dickersonbetry-alt/-fpga-/rk3588/ball_v2/confusion_matrix.png

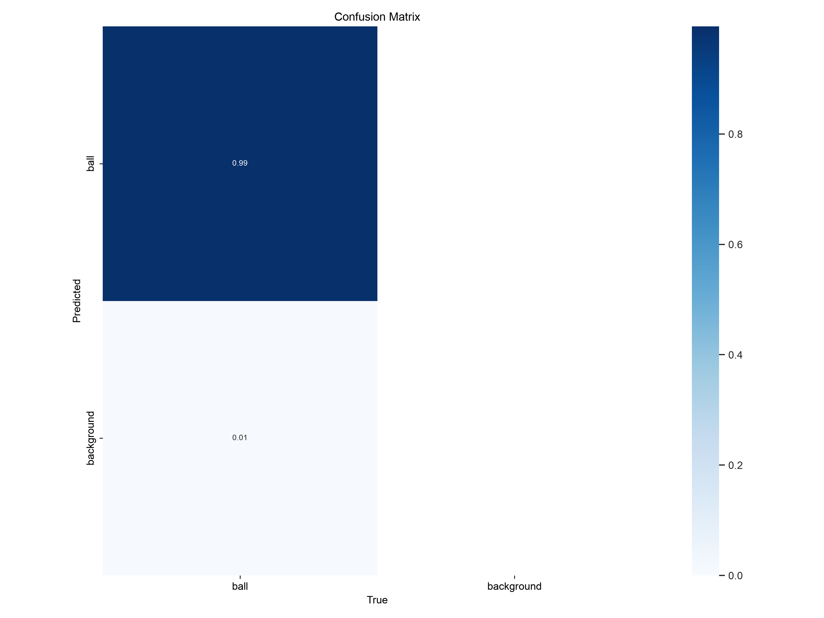
rk3588/ball_v2/confusion_matrix.png
