dickersonbetry-alt/-fpga-/rk3588/ball_v2/F1_curve.png

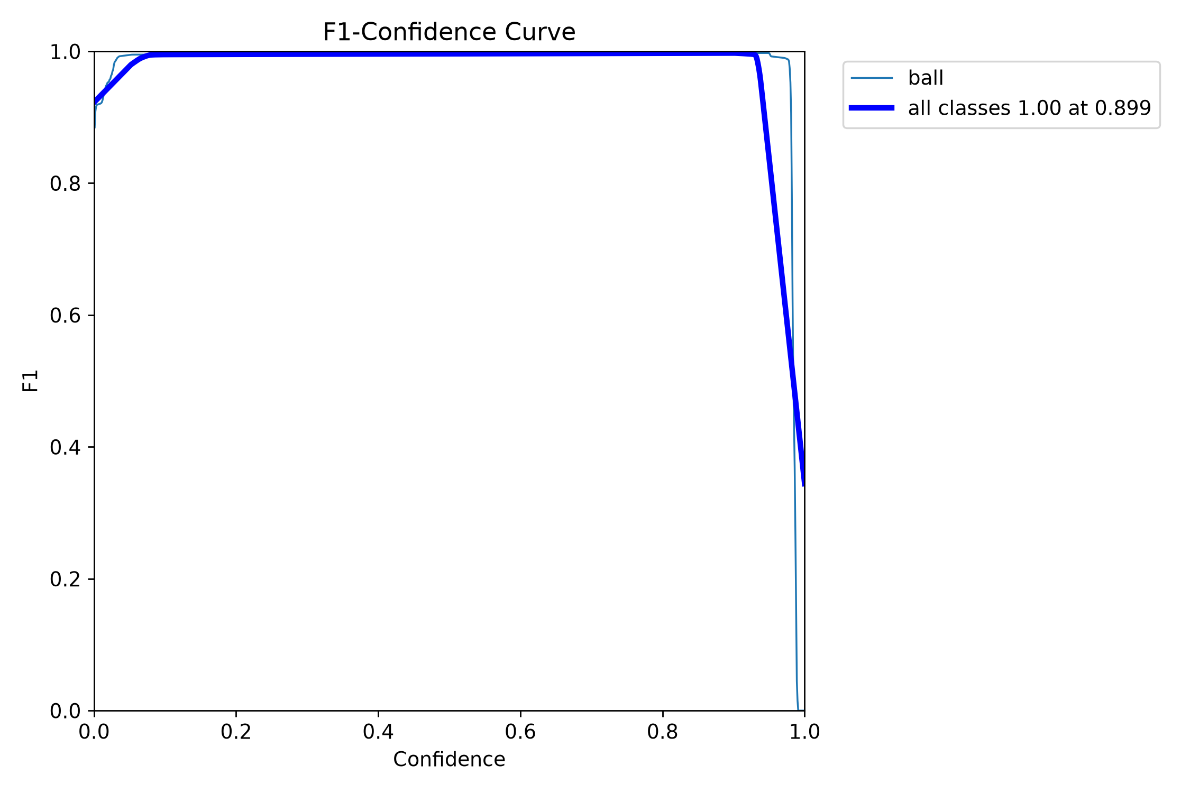
rk3588/ball_v2/F1_curve.png
