dickersonbetry-alt/-fpga-/rk3588/ball_v2/labels.jpg

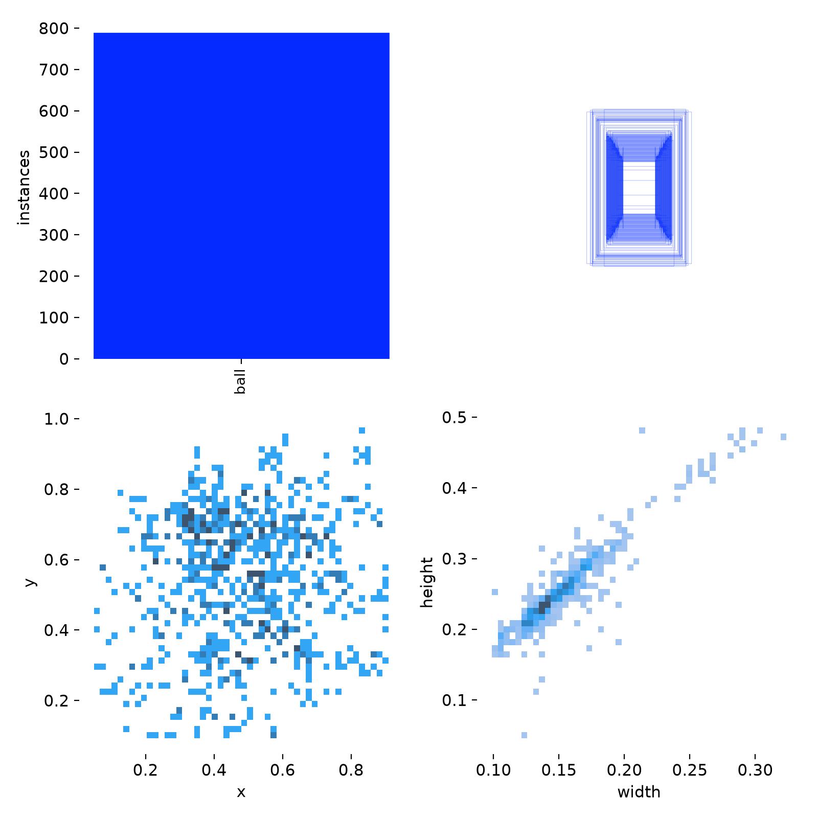
rk3588/ball_v2/labels.jpg
