dickersonbetry-alt/-fpga-/rk3588/ball_v2/labels_correlogram.jpg

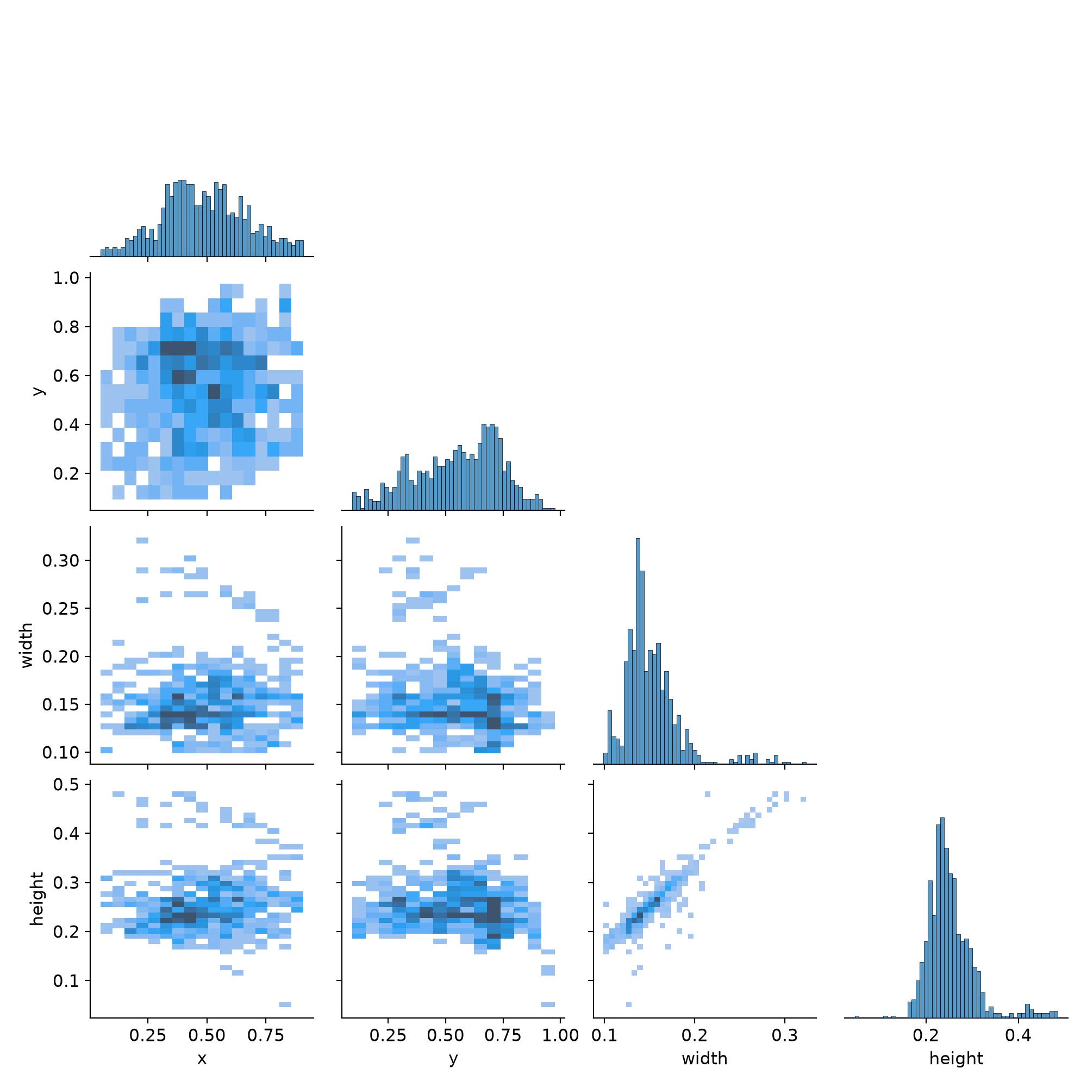
rk3588/ball_v2/labels_correlogram.jpg
