dickersonbetry-alt/-fpga-/rk3588/ball_v2/PR_curve.png

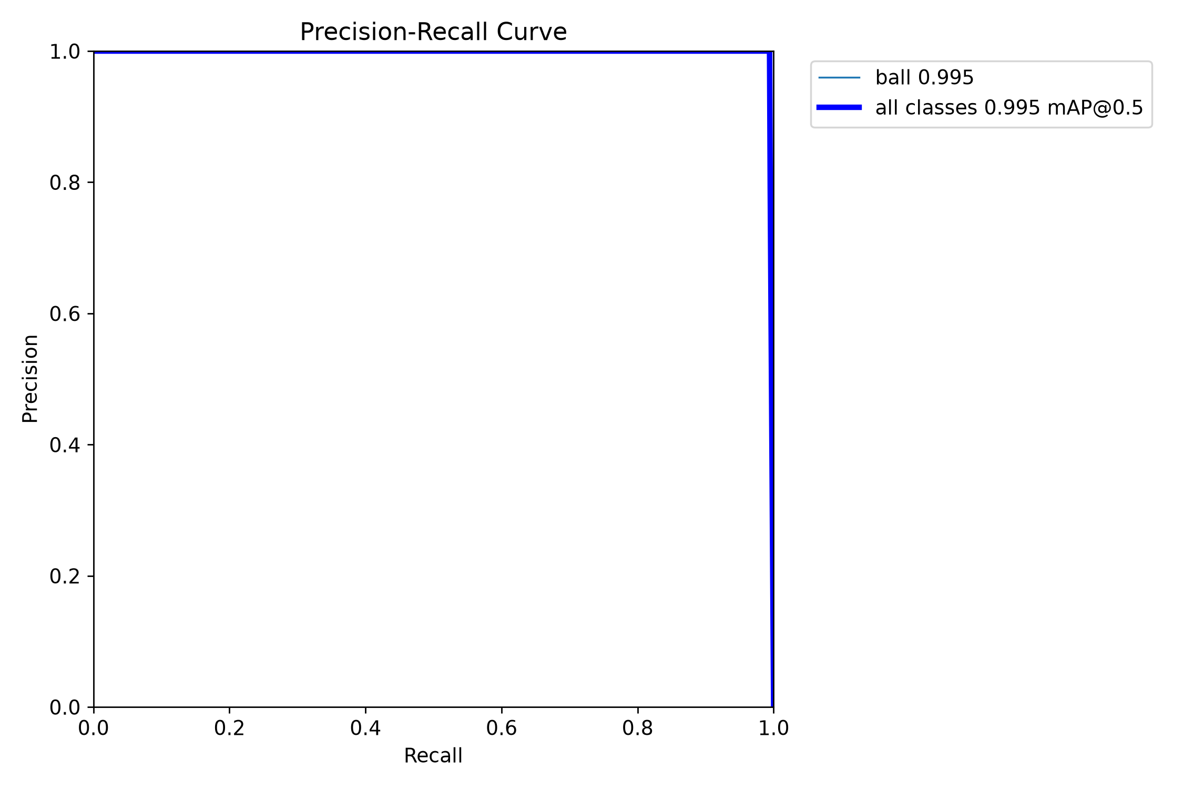
rk3588/ball_v2/PR_curve.png
