dickersonbetry-alt/-fpga-/rk3588/ball_v2/train_batch0.jpg

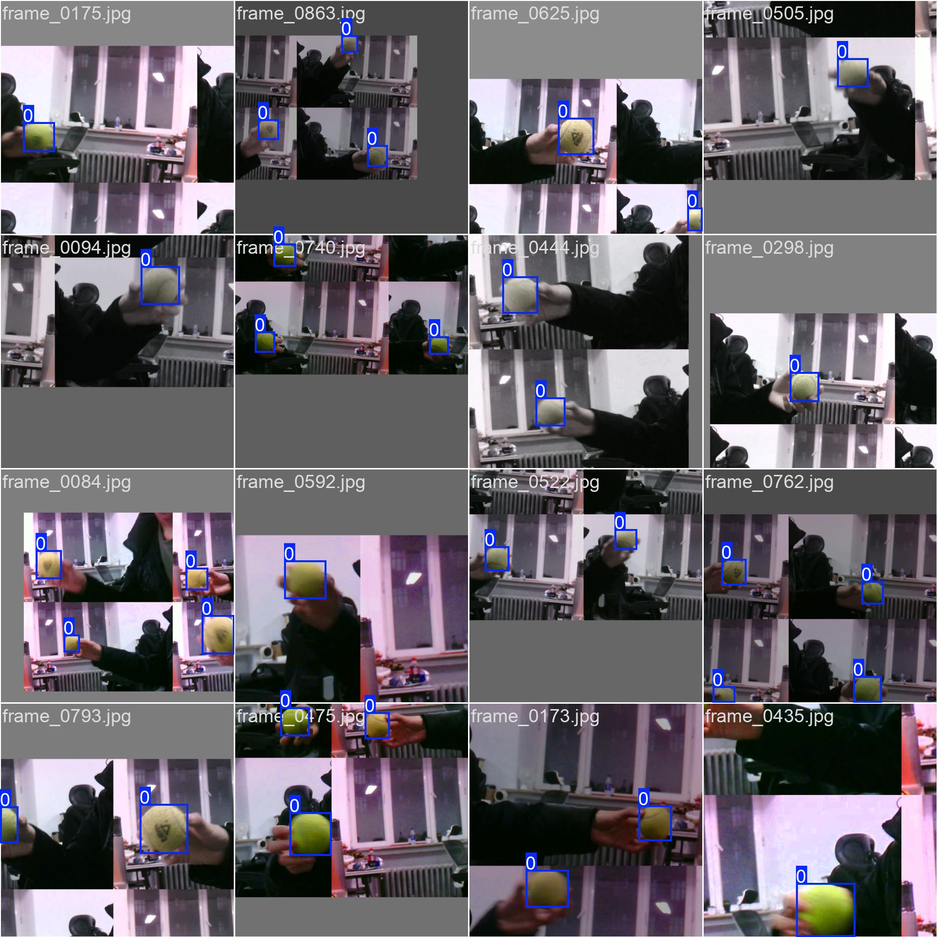
rk3588/ball_v2/train_batch0.jpg
