dickersonbetry-alt/-fpga-/rk3588/ball_v2/train_batch1.jpg

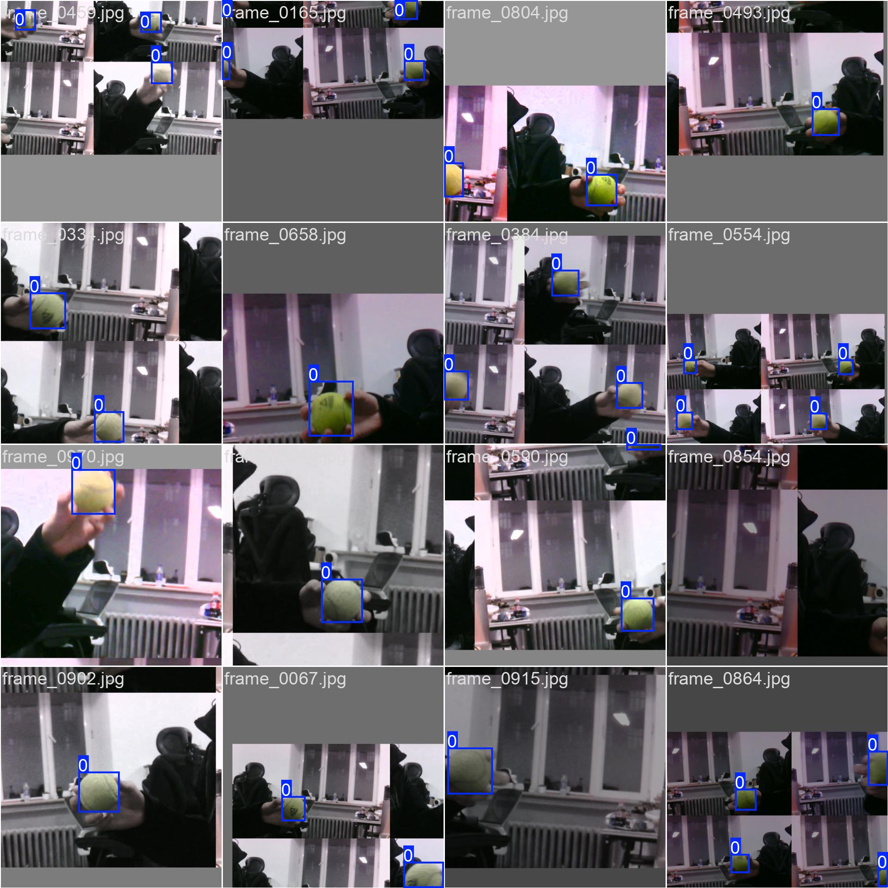
rk3588/ball_v2/train_batch1.jpg
