dickersonbetry-alt/-fpga-/rk3588/ball_v2/train_batch2.jpg

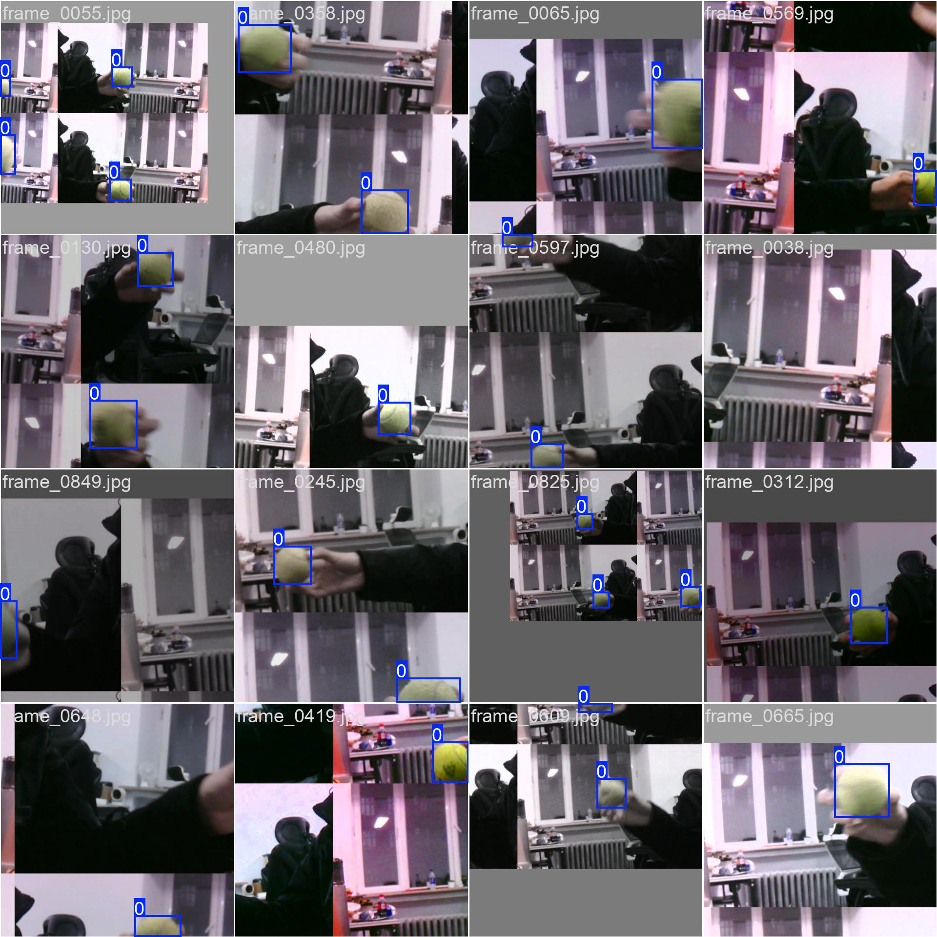
rk3588/ball_v2/train_batch2.jpg
