dickersonbetry-alt/-fpga-/rk3588/ball_v2/val_batch1_labels.jpg

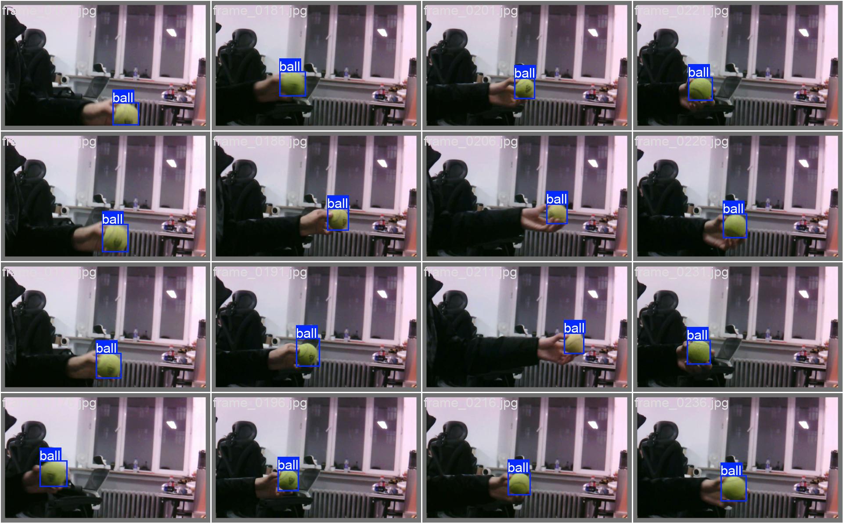
rk3588/ball_v2/val_batch1_labels.jpg
