dickersonbetry-alt/-fpga-/fpga/sw/52B_ASM.SLDASM

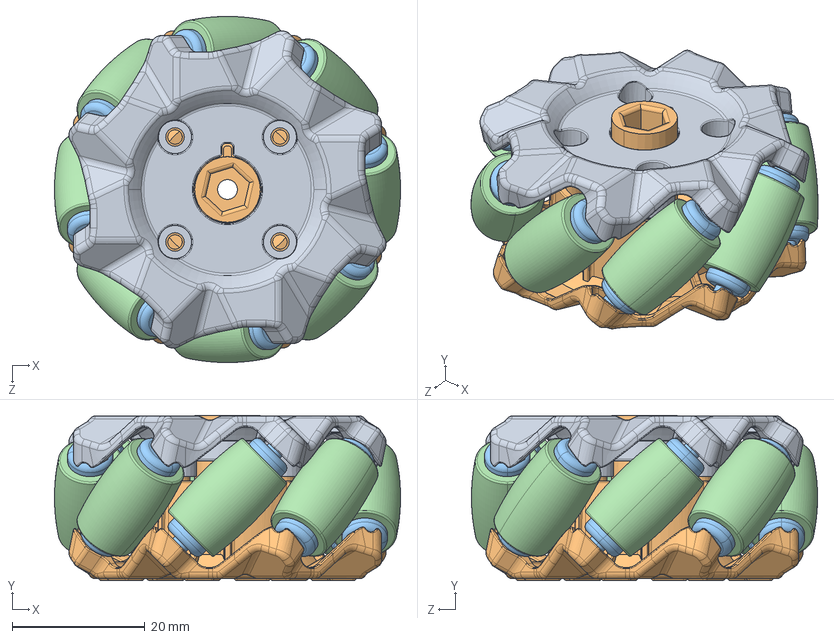
[picture p13: CAD file, 2026-11-04]
fpga/sw/52B_ASM.SLDASM
52.1 x 24.9 x 52.1 mm
L4 x 8
L5 x 8
52B
52B-D
