dickersonbetry-alt/-fpga-/fpga/sw/LLL45_ASM.SLDASM

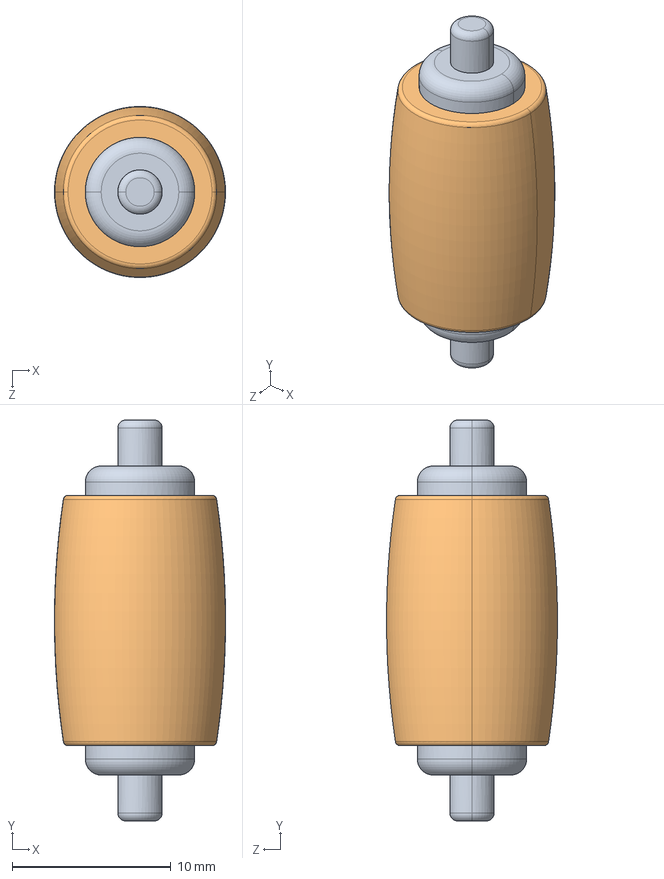
[picture p14: CAD file, 2026-11-04]
fpga/sw/LLL45_ASM.SLDASM
10.8 x 25.3 x 10.8 mm
L4
L5
