dickersonbetry-alt/-fpga-/fpga/sw/麦轮.SLDASM

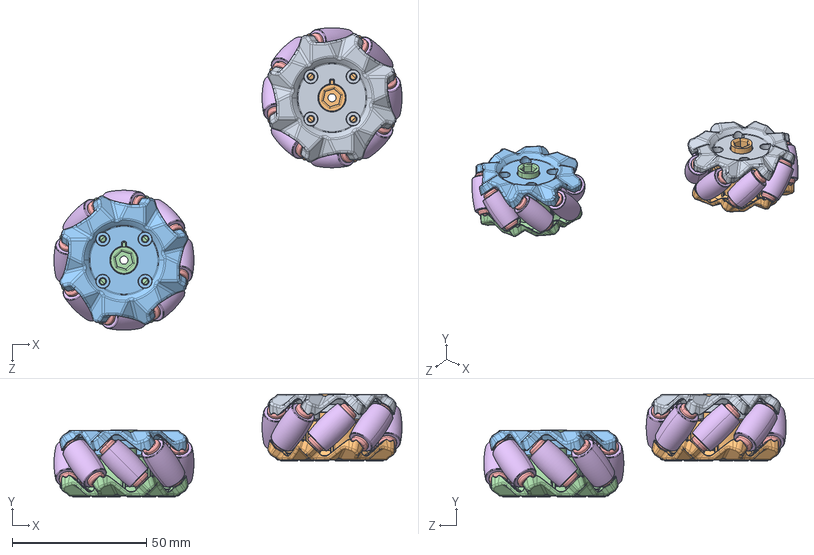
[picture p15: CAD file, 2026-11-04]
fpga/sw/麦轮.SLDASM
129.5 x 38.3 x 112.5 mm
L4 x 16
L5 x 16
52A
52A-D
52B
52B-D
