dickersonbetry-alt/-fpga-/fpga/sw/底盘-装配体.SLDASM

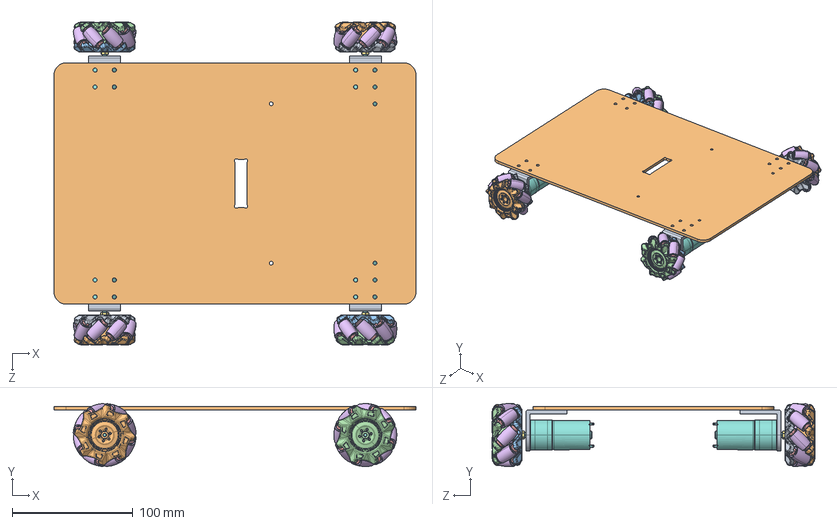
[picture p16: CAD file, 2026-11-04]
fpga/sw/底盘-装配体.SLDASM
300.0 x 52.2 x 267.7 mm
底盘
25支架 x 4
JGA25-370常规.step x 4
六角联轴器D孔5.9 x 4
L4 x 32
L5 x 32
52A x 2
52A-D x 2
52B x 2
52B-D x 2
