dickersonbetry-alt/-fpga-/fpga/sw/底盘.SLDPRT

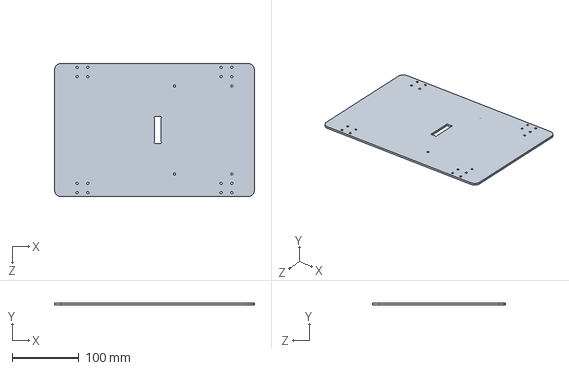
[picture p17: CAD file, 2026-11-04]
fpga/sw/底盘.SLDPRT
300.0 x 3.00 x 200.0 mm
