dickersonbetry-alt/-fpga-/fpga/sw/SG_178.SLDPRT

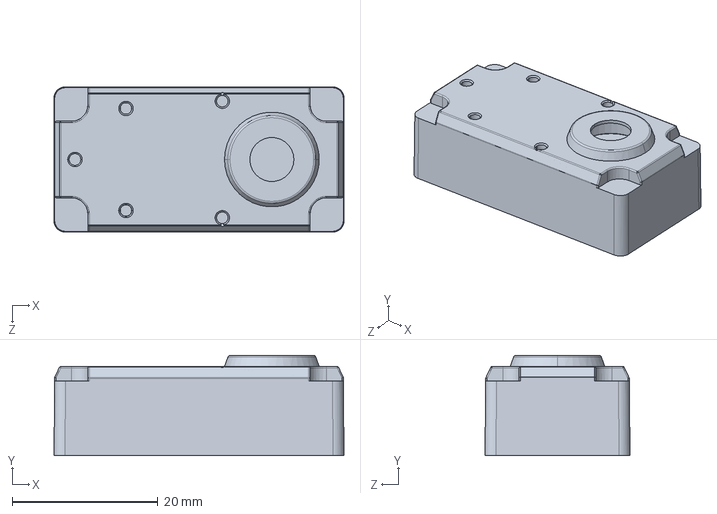
[picture p18: CAD file, 2026-11-04]
fpga/sw/SG_178.SLDPRT
39.8 x 13.8 x 19.9 mm
