dickersonbetry-alt/-fpga-/fpga/sw/L5.SLDPRT

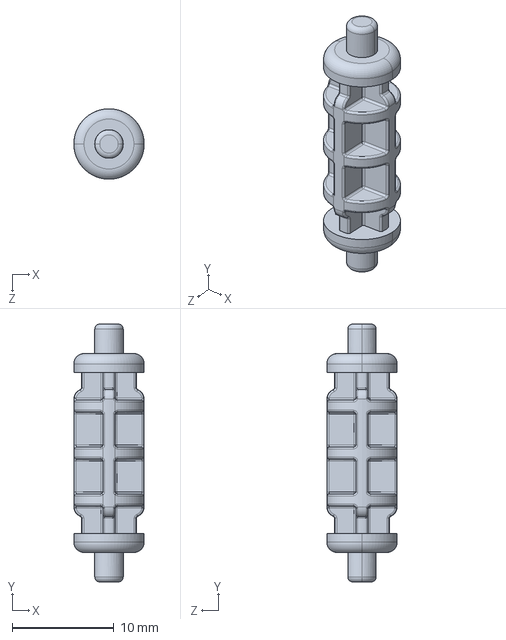
[picture p19: CAD file, 2026-11-04]
fpga/sw/L5.SLDPRT
6.90 x 25.3 x 6.90 mm
