dickersonbetry-alt/-fpga-/fpga/sw/DUOPAN-SG.SLDPRT

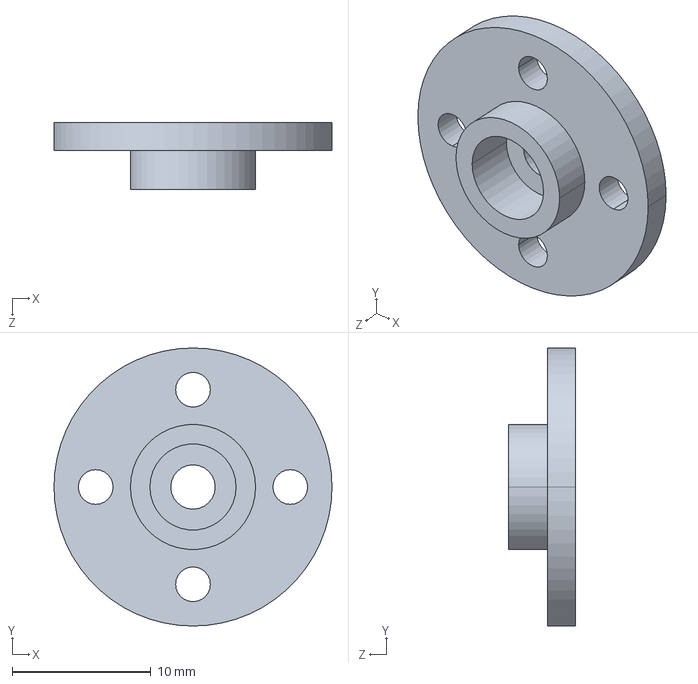
[picture p20: CAD file, 2026-11-04]
fpga/sw/DUOPAN-SG.SLDPRT
20.0 x 20.0 x 4.80 mm
