dickersonbetry-alt/-fpga-/fpga/sw/52B-D.SLDPRT

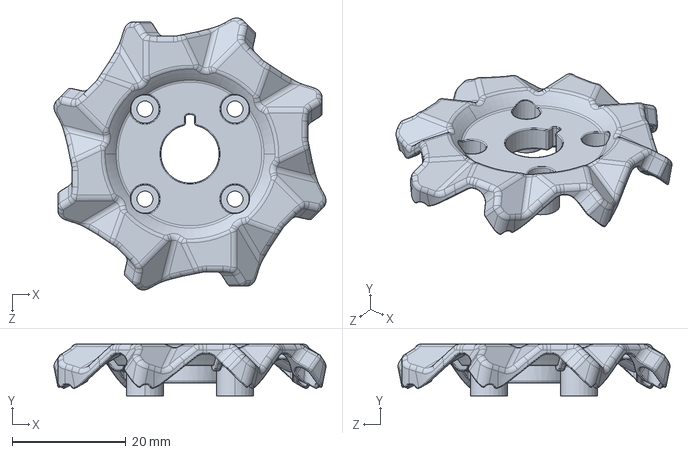
[picture p21: CAD file, 2026-11-04]
fpga/sw/52B-D.SLDPRT
47.7 x 9.10 x 47.7 mm
