dickersonbetry-alt/-fpga-/fpga/sw/LV-DUOBAN.SLDPRT

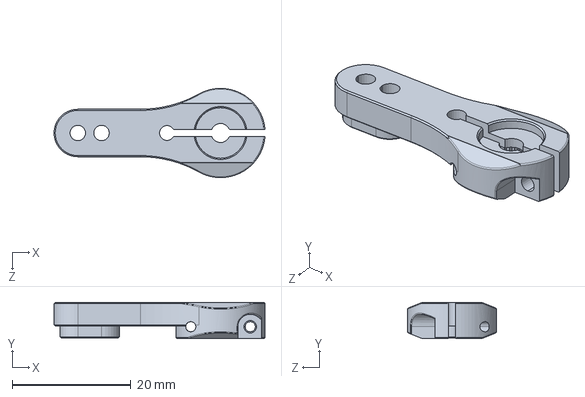
[picture p22: CAD file, 2026-11-04]
fpga/sw/LV-DUOBAN.SLDPRT
35.5 x 6.10 x 15.0 mm
