dickersonbetry-alt/-fpga-/fpga/sw/六角联轴器D孔5.9.SLDPRT

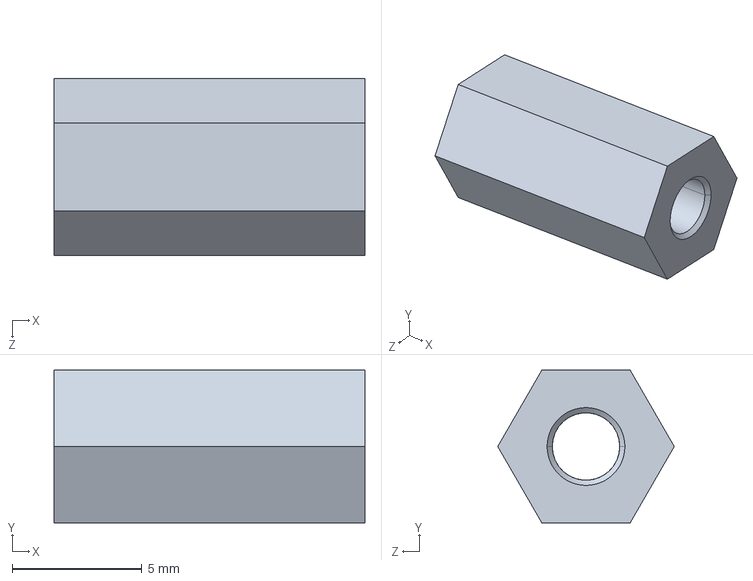
[picture p23: CAD file, 2026-11-04]
fpga/sw/六角联轴器D孔5.9.SLDPRT
12.0 x 5.90 x 6.81 mm
