dickersonbetry-alt/-fpga-/fpga/sw/DUOPAN-DG.SLDPRT

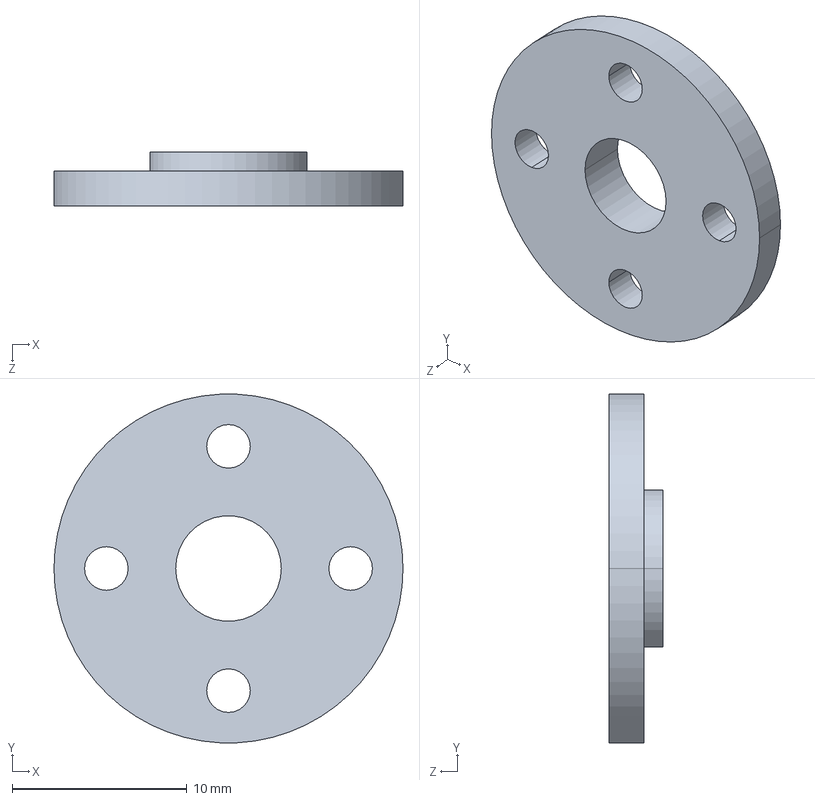
[picture p24: CAD file, 2026-11-04]
fpga/sw/DUOPAN-DG.SLDPRT
20.0 x 20.0 x 3.10 mm
