dickersonbetry-alt/-fpga-/fpga/sw/52B.SLDPRT

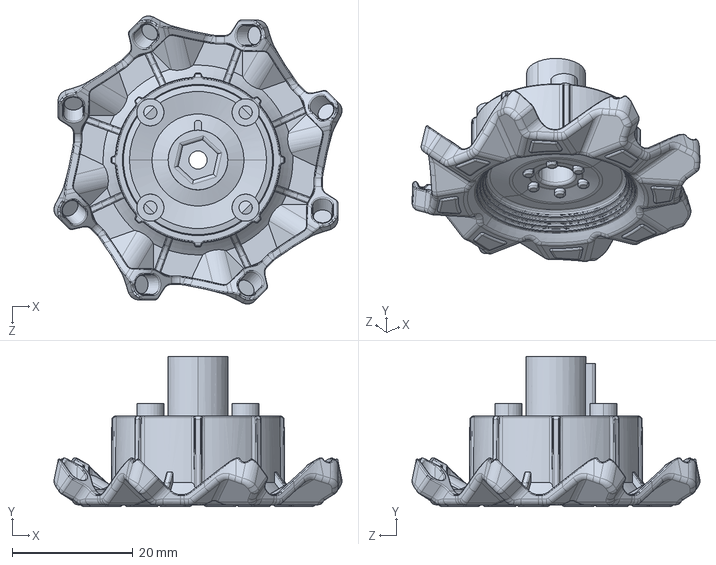
[picture p25: CAD file, 2026-11-04]
fpga/sw/52B.SLDPRT
47.7 x 24.9 x 47.7 mm
