dickersonbetry-alt/-fpga-/fpga/sw/DG_130.SLDPRT

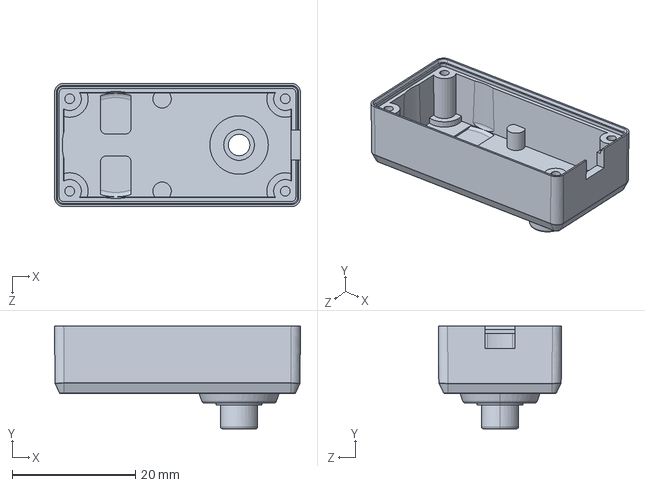
[picture p26: CAD file, 2026-11-04]
fpga/sw/DG_130.SLDPRT
39.9 x 16.7 x 20.0 mm
