dickersonbetry-alt/-fpga-/fpga/sw/ZK.SLDPRT

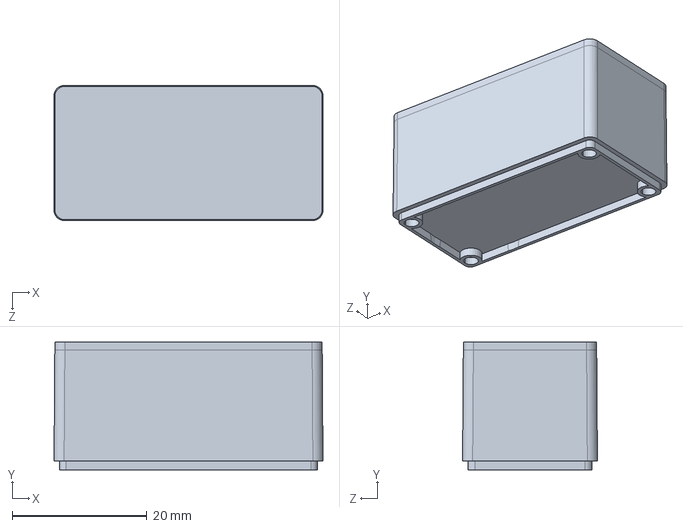
[picture p27: CAD file, 2026-11-04]
fpga/sw/ZK.SLDPRT
39.9 x 19.0 x 20.0 mm
