dickersonbetry-alt/-fpga-/fpga/sw/JGA25-370常规.step.SLDPRT

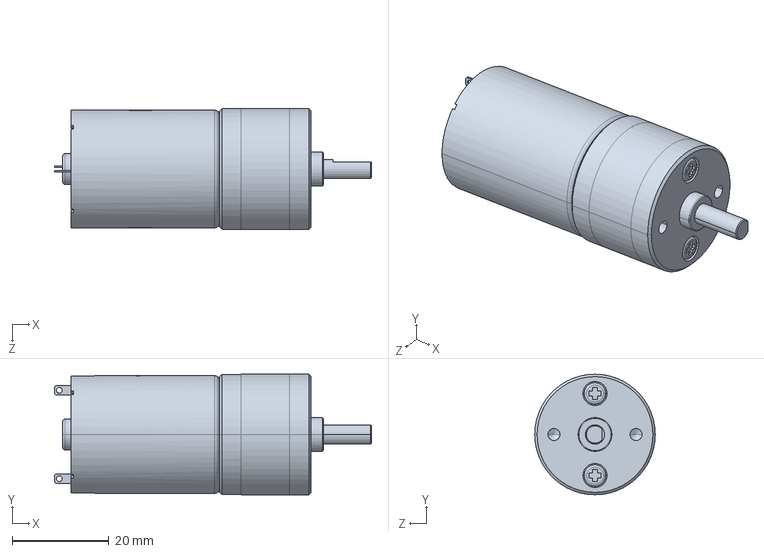
[picture p28: CAD file, 2026-11-04]
fpga/sw/JGA25-370常规.step.SLDPRT
65.7 x 25.0 x 25.0 mm
