dickersonbetry-alt/-fpga-/fpga/sw/ZJ-DUAN.SLDPRT

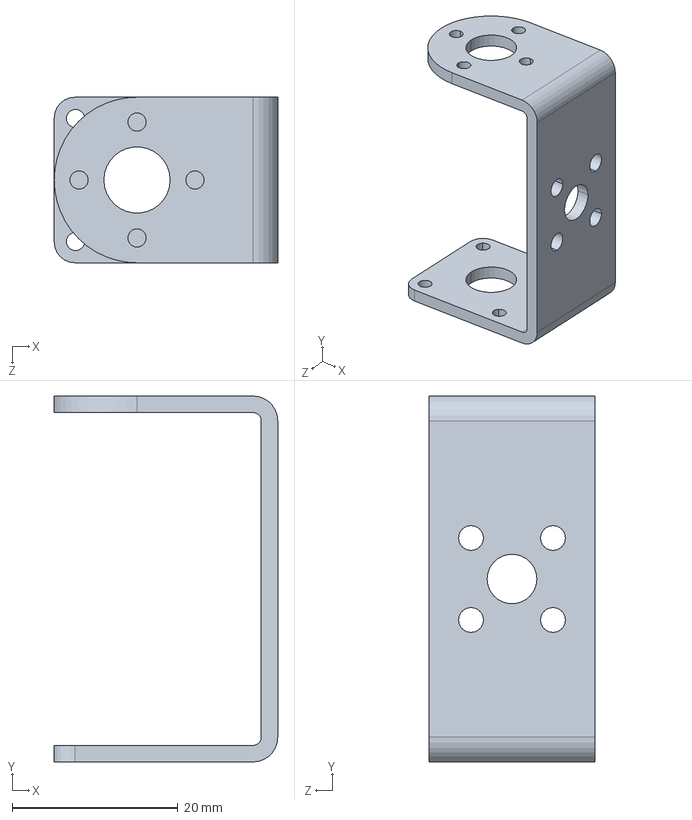
[picture p29: CAD file, 2026-11-04]
fpga/sw/ZJ-DUAN.SLDPRT
27.0 x 44.2 x 20.0 mm
