dickersonbetry-alt/-fpga-/fpga/sw/ZJ-CHANG.SLDPRT

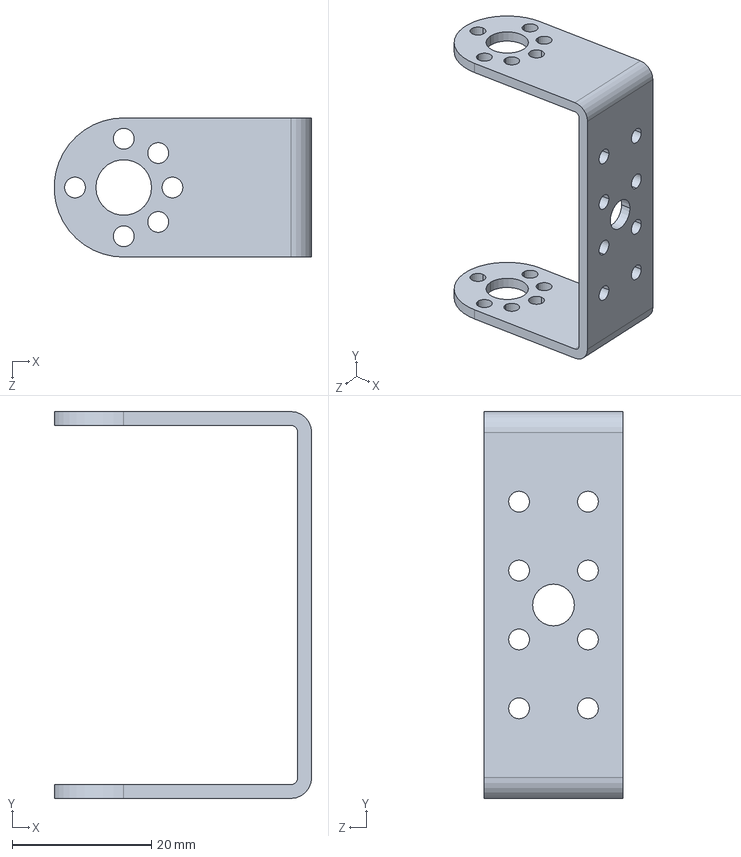
[picture p30: CAD file, 2026-11-04]
fpga/sw/ZJ-CHANG.SLDPRT
37.0 x 55.6 x 20.0 mm
