dickersonbetry-alt/-fpga-/fpga/sw/GE.SLDPRT

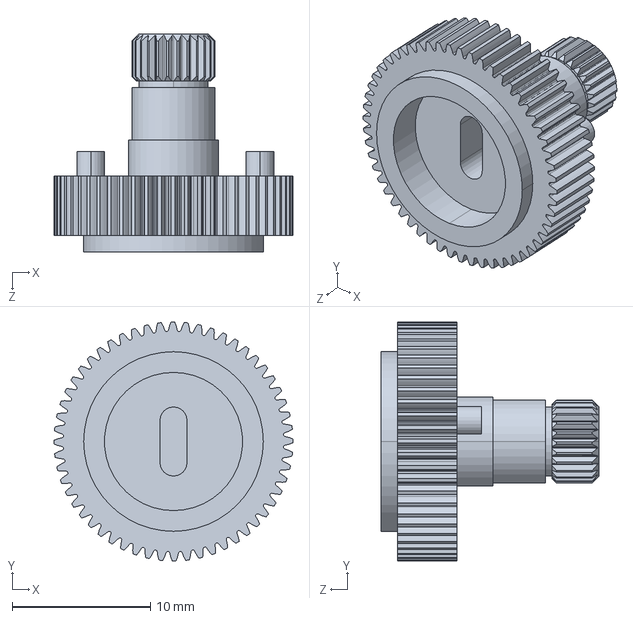
[picture p31: CAD file, 2026-11-04]
fpga/sw/GE.SLDPRT
17.3 x 17.3 x 15.8 mm
