dickersonbetry-alt/-fpga-/fpga/sw/SG-JIANRONG-MG996.SLDPRT

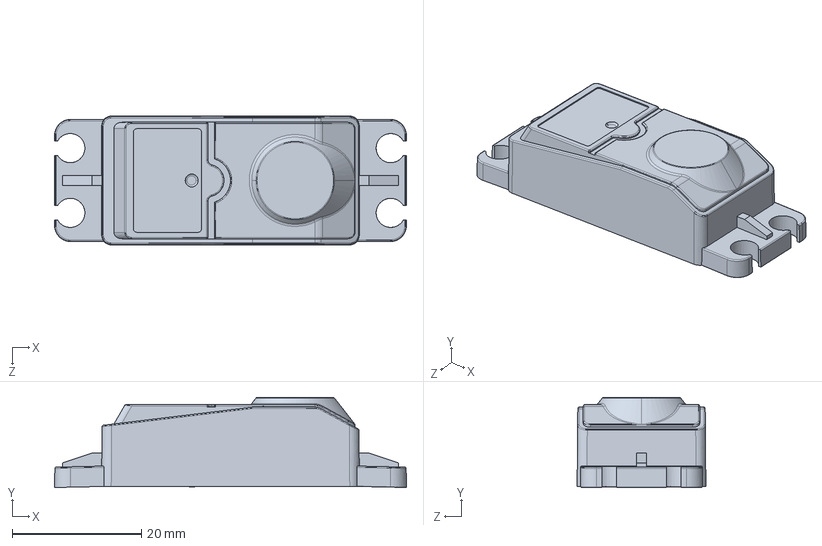
[picture p32: CAD file, 2026-11-04]
fpga/sw/SG-JIANRONG-MG996.SLDPRT
54.4 x 13.9 x 19.9 mm
