dickersonbetry-alt/-fpga-/fpga/sw/L4.SLDPRT

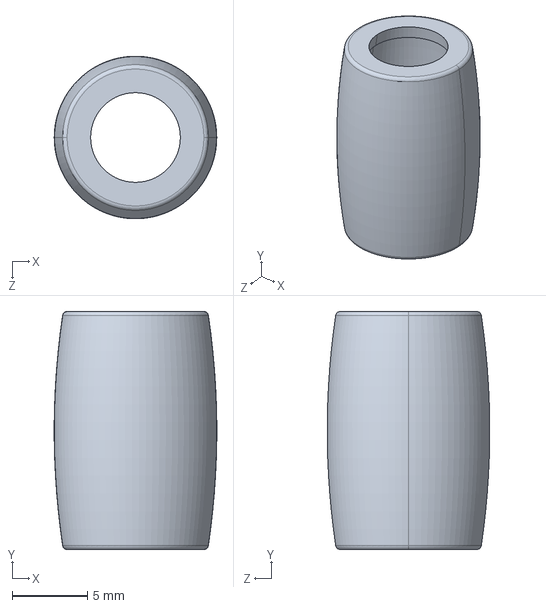
[picture p33: CAD file, 2026-11-04]
fpga/sw/L4.SLDPRT
10.8 x 15.8 x 10.8 mm
