dickersonbetry-alt/-fpga-/fpga/sw/GE_57.SLDPRT

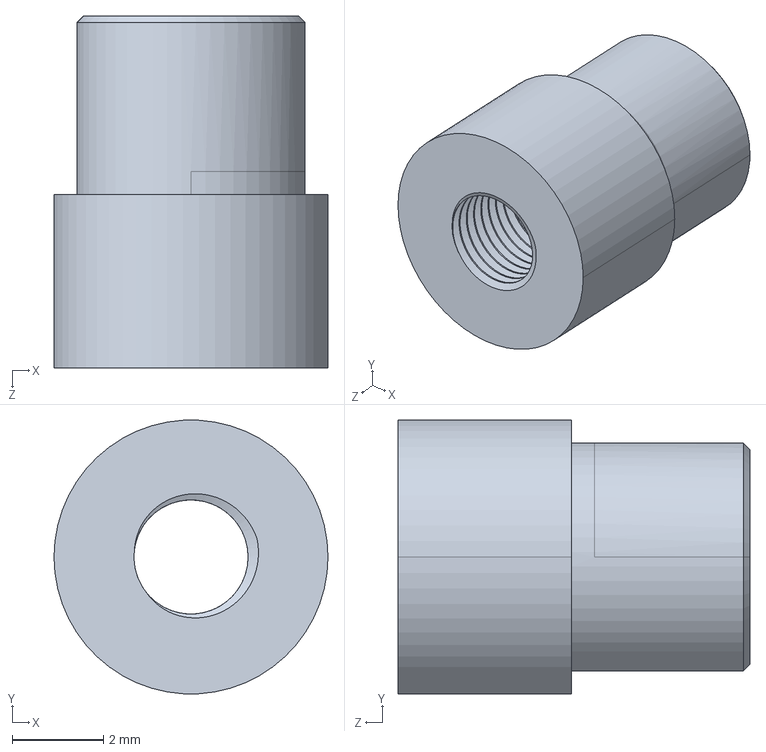
[picture p34: CAD file, 2026-11-04]
fpga/sw/GE_57.SLDPRT
6.00 x 5.99 x 7.70 mm
