dickersonbetry-alt/-fpga-/fpga/sw/DG-SZ.SLDPRT

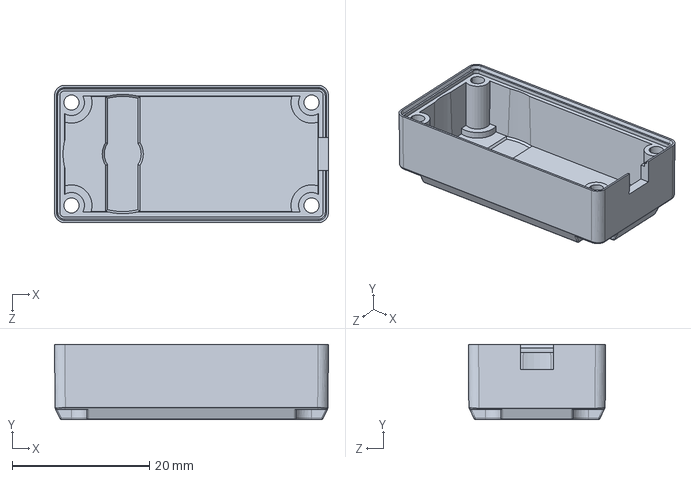
[picture p35: CAD file, 2026-11-04]
fpga/sw/DG-SZ.SLDPRT
39.9 x 11.0 x 20.0 mm
