dickersonbetry-alt/-fpga-/fpga/sw/XIANTAO.SLDPRT

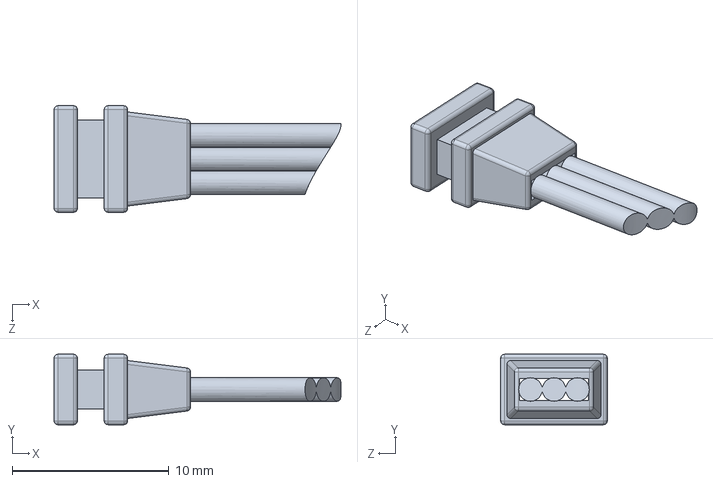
[picture p36: CAD file, 2026-11-04]
fpga/sw/XIANTAO.SLDPRT
18.3 x 4.50 x 6.80 mm
