dickersonbetry-alt/-fpga-/fpga/sw/ZK_142.SLDPRT

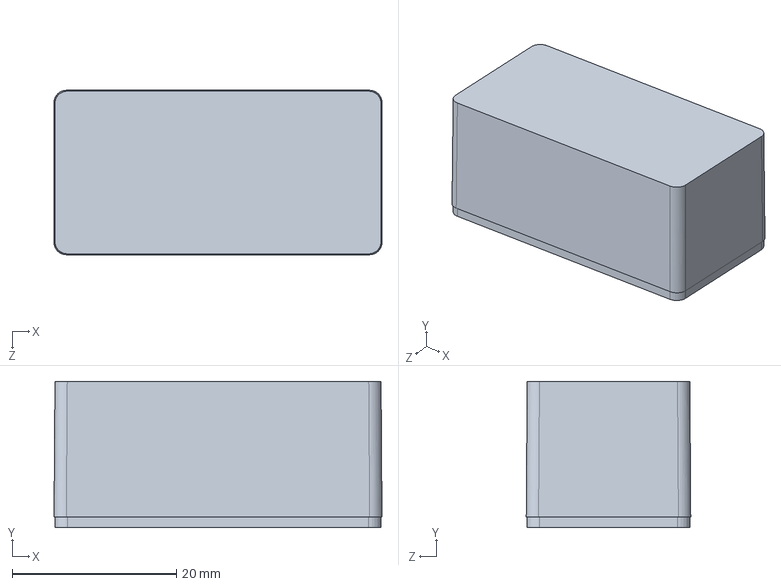
[picture p37: CAD file, 2026-11-04]
fpga/sw/ZK_142.SLDPRT
39.9 x 17.8 x 20.0 mm
