dickersonbetry-alt/-fpga-/fpga/sw/25支架.SLDPRT

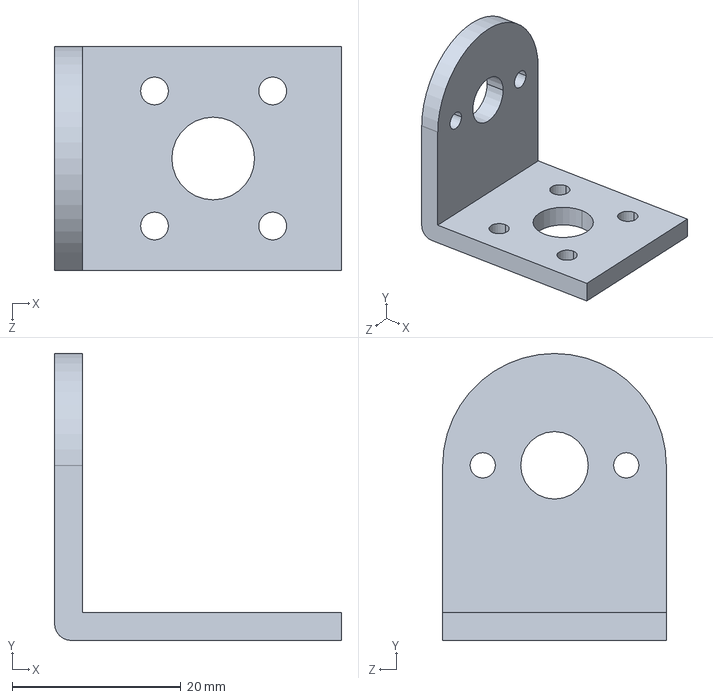
[picture p38: CAD file, 2026-11-04]
fpga/sw/25支架.SLDPRT
34.0 x 34.0 x 26.5 mm
