dickersonbetry-alt/-fpga-/(list of files, cad)

Other CAD files:
fpga/sw/52A_ASM.SLDASM
fpga/sw/舵盘.SLDPRT
fpga/sw/52A.SLDPRT
fpga/sw/52A-D.SLDPRT
