dickersonbetry-alt/-fpga-/rk3588/ball_v2/results.csv

epoch | train/box_loss | train/obj_loss | train/cls_loss | metrics/precision | metrics/recall | metrics/mAP_0.5 | metrics/mAP_0.5:0.95 | val/box_loss | val/obj_loss | val/cls_loss | x/lr0 | x/lr1 | x/lr2
0 | 0.08212 | 0.029076 | 0 | 0.62968 | 0.8392 | 0.71995 | 0.32645 | 0.063461 | 0.018155 | 0 | 0.0706 | 0.0032667 | 0.0032667
1 | 0.061942 | 0.019922 | 0 | 0.93483 | 0.79286 | 0.89935 | 0.30502 | 0.053651 | 0.012853 | 0 | 0.040598 | 0.0065984 | 0.0065984
2 | 0.054963 | 0.016613 | 0 | 0.64089 | 0.75331 | 0.77919 | 0.38386 | 0.053742 | 0.0097041 | 0 | 0.01059 | 0.0099236 | 0.0099236
3 | 0.047467 | 0.013687 | 0 | 0.99494 | 0.98812 | 0.9934 | 0.41285 | 0.042757 | 0.0084805 | 0 | 0.009978 | 0.009978 | 0.009978
4 | 0.039172 | 0.011337 | 0 | 0.9848 | 0.97649 | 0.99367 | 0.77646 | 0.021569 | 0.0061 | 0 | 0.009978 | 0.009978 | 0.009978
5 | 0.034418 | 0.0094912 | 0 | 0.97757 | 0.97487 | 0.99258 | 0.66221 | 0.026049 | 0.0056898 | 0 | 0.009961 | 0.009961 | 0.009961
6 | 0.033099 | 0.0085384 | 0 | 0.98937 | 0.99497 | 0.9949 | 0.59951 | 0.032662 | 0.005595 | 0 | 0.0099391 | 0.0099391 | 0.0099391
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
