dickersonbetry-alt/-fpga-/rk3588/ball_v2/results.png

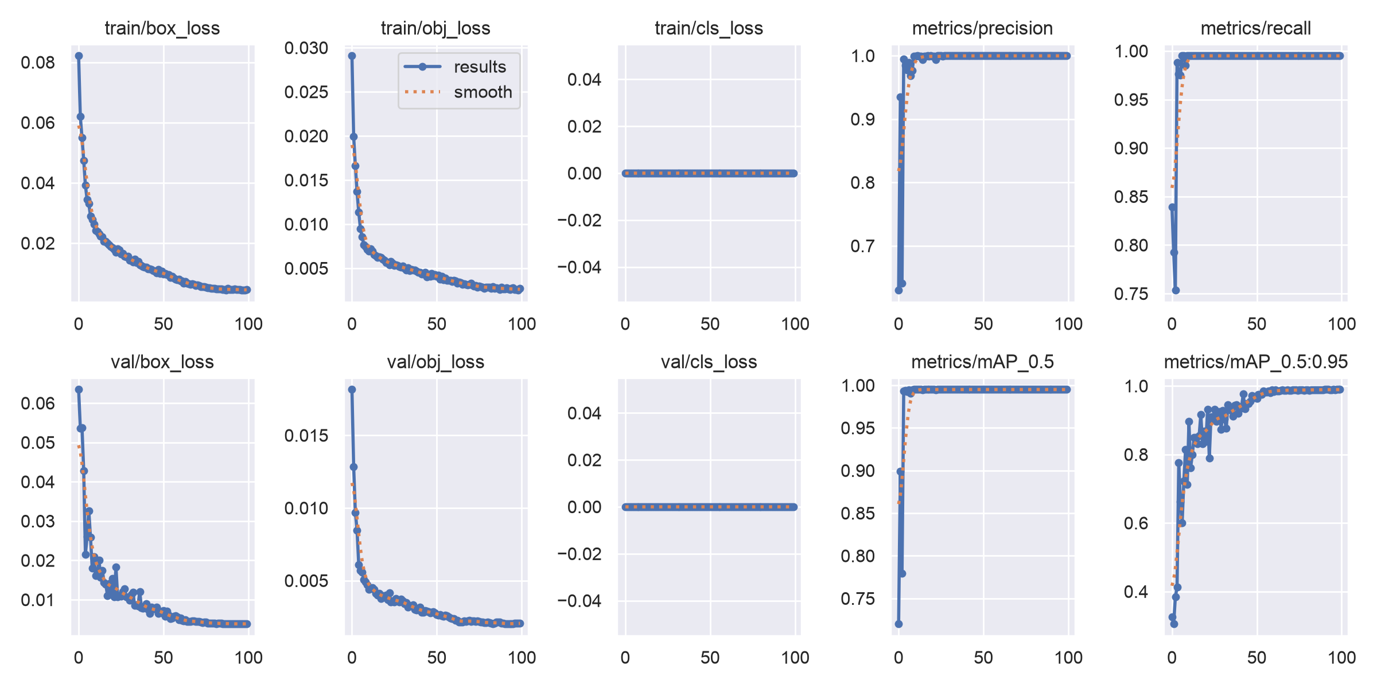
rk3588/ball_v2/results.png
