dickersonbetry-alt/-fpga-/fpga/acg720_138_piano/src/pin.xdc

#-------------------------sys_input---------------------------------
#set UnusedPin
set_property BITSTREAM.CONFIG.UNUSEDPIN Pullnone [current_design]

#system slock
set_property PACKAGE_PIN Y18 [get_ports clk]
set_property IOSTANDARD LVCMOS33 [get_ports clk]

#reset active low,S4
set_property PACKAGE_PIN B21 [get_ports rst_n]
set_property IOSTANDARD LVCMOS33 [get_ports rst_n]
#-------------------------------------------------------------------
#reset active low,S0
set_property PACKAGE_PIN F15 [get_ports key]
set_property IOSTANDARD LVCMOS33 [get_ports key]
#-------------------------------------------------------------------
#beep
set_property PACKAGE_PIN N19 [get_ports beep]
set_property IOSTANDARD LVCMOS33 [get_ports beep]
#----------------4.3寸TFT屏模块（使用扩展口GPIO2）--------------------
#TFT
set_property PACKAGE_PIN R17 [get_ports tft_clk]
set_property PACKAGE_PIN N17 [get_ports tft_de]
set_property PACKAGE_PIN R18 [get_ports tft_pwm]
set_property PACKAGE_PIN T18 [get_ports tft_hs]
set_property PACKAGE_PIN U18 [get_ports tft_vs]
set_property PACKAGE_PIN P5  [get_ports {tft_rgb[15]}]
set_property PACKAGE_PIN P4  [get_ports {tft_rgb[14]}]
set_property PACKAGE_PIN N3  [get_ports {tft_rgb[13]}]
set_property PACKAGE_PIN P2  [get_ports {tft_rgb[12]}]
set_property PACKAGE_PIN R1  [get_ports {tft_rgb[11]}]
set_property PACKAGE_PIN M5  [get_ports {tft_rgb[10]}]
set_property PACKAGE_PIN L6  [get_ports {tft_rgb[9]}]
set_property PACKAGE_PIN N5  [get_ports {tft_rgb[8]}]
set_property PACKAGE_PIN M6  [get_ports {tft_rgb[7]}]
set_property PACKAGE_PIN N4  [get_ports {tft_rgb[6]}]
set_property PACKAGE_PIN P6  [get_ports {tft_rgb[5]}]
set_property PACKAGE_PIN P17 [get_ports {tft_rgb[4]}]
set_property PACKAGE_PIN R14 [get_ports {tft_rgb[3]}]
set_property PACKAGE_PIN R16 [get_ports {tft_rgb[2]}]
set_property PACKAGE_PIN K6  [get_ports {tft_rgb[1]}]
set_property PACKAGE_PIN J5  [get_ports {tft_rgb[0]}]
set_property PACKAGE_PIN N13  [get_ports tp_int]
set_property PACKAGE_PIN P15  [get_ports tp_rst]
set_property PACKAGE_PIN N15  [get_ports tp_scl]
set_property PACKAGE_PIN P16  [get_ports tp_sda]
set_property PACKAGE_PIN F4  [get_ports seg_sclk]
set_property PACKAGE_PIN C2  [get_ports seg_rclk]
set_property PACKAGE_PIN M18  [get_ports seg_dio]

set_property IOSTANDARD LVCMOS33 [get_ports tft_clk]
set_property IOSTANDARD LVCMOS33 [get_ports tft_de]
set_property IOSTANDARD LVCMOS33 [get_ports tft_pwm]
set_property IOSTANDARD LVCMOS33 [get_ports tft_hs]
set_property IOSTANDARD LVCMOS33 [get_ports tft_vs]
set_property IOSTANDARD LVCMOS33 [get_ports {tft_rgb[15]}]
set_property IOSTANDARD LVCMOS33 [get_ports {tft_rgb[14]}]
set_property IOSTANDARD LVCMOS33 [get_ports {tft_rgb[13]}]
set_property IOSTANDARD LVCMOS33 [get_ports {tft_rgb[12]}]
set_property IOSTANDARD LVCMOS33 [get_ports {tft_rgb[11]}]
set_property IOSTANDARD LVCMOS33 [get_ports {tft_rgb[10]}]
set_property IOSTANDARD LVCMOS33 [get_ports {tft_rgb[9]}]
set_property IOSTANDARD LVCMOS33 [get_ports {tft_rgb[8]}]
set_property IOSTANDARD LVCMOS33 [get_ports {tft_rgb[7]}]
set_property IOSTANDARD LVCMOS33 [get_ports {tft_rgb[6]}]
set_property IOSTANDARD LVCMOS33 [get_ports {tft_rgb[5]}]
set_property IOSTANDARD LVCMOS33 [get_ports {tft_rgb[4]}]
set_property IOSTANDARD LVCMOS33 [get_ports {tft_rgb[3]}]
set_property IOSTANDARD LVCMOS33 [get_ports {tft_rgb[2]}]
set_property IOSTANDARD LVCMOS33 [get_ports {tft_rgb[1]}]
set_property IOSTANDARD LVCMOS33 [get_ports {tft_rgb[0]}]
set_property IOSTANDARD LVCMOS33 [get_ports tp_int]
set_property IOSTANDARD LVCMOS33 [get_ports tp_rst]
set_property IOSTANDARD LVCMOS33 [get_ports tp_scl]
set_property IOSTANDARD LVCMOS33 [get_ports tp_sda]
set_property IOSTANDARD LVCMOS33 [get_ports seg_sclk]
set_property IOSTANDARD LVCMOS33 [get_ports seg_rclk]
set_property IOSTANDARD LVCMOS33 [get_ports seg_dio]
#-------------------------------------------------------------------
