dickersonbetry-alt/-fpga-/fpga/acg720_138_piano/src/gowin_pll/gowin_pll_mod_tmp.v

//Copyright (C)2014-2026 Gowin Semiconductor Corporation.
//All rights reserved.
//File Title: Template file for instantiation
//Tool Version: V1.9.12.02_SP2 (64-bit)
//IP Version: 1.0
//Part Number: GW5AT-LV138PG484AC1/I0
//Device: GW5AT-138
//Device Version: B
//Created Time: Mon Sep 14 16:16:26 2026

//Change the instance name and port connections to the signal names
//--------Copy here to design--------

    Gowin_PLL_MOD your_instance_name(
        .lock(lock), //output lock
        .clkout0(clkout0), //output clkout0
        .clkout1(clkout1), //output clkout1
        .clkin(clkin), //input clkin
        .reset(reset), //input reset
        .icpsel(icpsel), //input [5:0] icpsel
        .lpfres(lpfres), //input [2:0] lpfres
        .lpfcap(lpfcap) //input [1:0] lpfcap
    );

//--------Copy end-------------------
