dickersonbetry-alt/-fpga-/fpga/acg720_138_piano/src/pll/pll_stub.v

// Copyright 1986-2018 Xilinx, Inc. All Rights Reserved.
// --------------------------------------------------------------------------------
// Tool Version: Vivado v.2018.3 (win64) Build 2405991 Thu Dec  6 23:38:27 MST 2018
// Date        : Thu May 27 17:55:38 2021
// Host        : USER-20181220OH running 64-bit major release  (build 9200)
// Command     : write_verilog -force -mode synth_stub K:/Workkkkkkkk/acx720_piano/acx720_piano/rtl/pll/pll_stub.v
// Design      : pll
// Purpose     : Stub declaration of top-level module interface
// Device      : xc7a35tfgg484-2
// --------------------------------------------------------------------------------

// This empty module with port declaration file causes synthesis tools to infer a black box for IP.
// The synthesis directives are for Synopsys Synplify support to prevent IO buffer insertion.
// Please paste the declaration into a Verilog source file or add the file as an additional source.
module pll(clk_out1, clk_out2, resetn, locked, clk_in1)
/* synthesis syn_black_box black_box_pad_pin="clk_out1,clk_out2,resetn,locked,clk_in1" */;
  output clk_out1;
  output clk_out2;
  input resetn;
  output locked;
  input clk_in1;
endmodule
