dickersonbetry-alt/-fpga-/fpga/acg720_138_piano/src/pll/pll_stub.vhdl

-- Copyright 1986-2018 Xilinx, Inc. All Rights Reserved.
-- --------------------------------------------------------------------------------
-- Tool Version: Vivado v.2018.3 (win64) Build 2405991 Thu Dec  6 23:38:27 MST 2018
-- Date        : Thu May 27 17:55:38 2021
-- Host        : USER-20181220OH running 64-bit major release  (build 9200)
-- Command     : write_vhdl -force -mode synth_stub K:/Workkkkkkkk/acx720_piano/acx720_piano/rtl/pll/pll_stub.vhdl
-- Design      : pll
-- Purpose     : Stub declaration of top-level module interface
-- Device      : xc7a35tfgg484-2
-- --------------------------------------------------------------------------------
library IEEE;
use IEEE.STD_LOGIC_1164.ALL;

entity pll is
  Port ( 
    clk_out1 : out STD_LOGIC;
    clk_out2 : out STD_LOGIC;
    resetn : in STD_LOGIC;
    locked : out STD_LOGIC;
    clk_in1 : in STD_LOGIC
  );

end pll;

architecture stub of pll is
attribute syn_black_box : boolean;
attribute black_box_pad_pin : string;
attribute syn_black_box of stub : architecture is true;
attribute black_box_pad_pin of stub : architecture is "clk_out1,clk_out2,resetn,locked,clk_in1";
begin
end;
