dickersonbetry-alt/-fpga-/fpga/fpga_project/src/camera/gowin_pll/gowin_pll_tmp.v

//Copyright (C)2014-2024 Gowin Semiconductor Corporation.
//All rights reserved.
//File Title: Template file for instantiation
//Tool Version: V1.9.9.01 (64-bit)
//Part Number: GW5AT-LV138PG484AC1/I0
//Device: GW5AT-138
//Device Version: B
//Created Time: Sun Sep 29 17:45:26 2024

//Change the instance name and port connections to the signal names
//--------Copy here to design--------

    Gowin_PLL your_instance_name(
        .lock(lock_o), //output lock
        .clkout0(clkout0_o), //output clkout0
        .clkout1(clkout1_o), //output clkout1
        .clkout2(clkout2_o), //output clkout2
        .clkout3(clkout3_o), //output clkout3
        .clkin(clkin_i), //input clkin
        .reset(reset_i) //input reset
    );

//--------Copy end-------------------
