dickersonbetry-alt/-fpga-/fpga/fpga_project/src/camera/rd_data_fifo/rd_data_fifo_tmp.v

//Copyright (C)2014-2024 Gowin Semiconductor Corporation.
//All rights reserved.
//File Title: Template file for instantiation
//Tool Version: V1.9.9.01 (64-bit)
//Part Number: GW5AT-LV138PG484AC1/I0
//Device: GW5AT-138
//Device Version: B
//Created Time: Sun Sep 29 17:44:30 2024

//Change the instance name and port connections to the signal names
//--------Copy here to design--------

	rd_data_fifo your_instance_name(
		.Data(Data_i), //input [127:0] Data
		.Reset(Reset_i), //input Reset
		.WrClk(WrClk_i), //input WrClk
		.RdClk(RdClk_i), //input RdClk
		.WrEn(WrEn_i), //input WrEn
		.RdEn(RdEn_i), //input RdEn
		.Wnum(Wnum_o), //output [9:0] Wnum
		.Rnum(Rnum_o), //output [12:0] Rnum
		.Almost_Empty(Almost_Empty_o), //output Almost_Empty
		.Almost_Full(Almost_Full_o), //output Almost_Full
		.Q(Q_o), //output [15:0] Q
		.Empty(Empty_o), //output Empty
		.Full(Full_o) //output Full
	);

//--------Copy end-------------------
