dickersonbetry-alt/-fpga-/fpga/acg720_138_piano/src/pll/pll_sim_netlist.vhdl

-- Copyright 1986-2018 Xilinx, Inc. All Rights Reserved.
-- --------------------------------------------------------------------------------
-- Tool Version: Vivado v.2018.3 (win64) Build 2405991 Thu Dec  6 23:38:27 MST 2018
-- Date        : Thu May 27 17:55:38 2021
-- Host        : USER-20181220OH running 64-bit major release  (build 9200)
-- Command     : write_vhdl -force -mode funcsim K:/Workkkkkkkk/acx720_piano/acx720_piano/rtl/pll/pll_sim_netlist.vhdl
-- Design      : pll
-- Purpose     : This VHDL netlist is a functional simulation representation of the design and should not be modified or
--               synthesized. This netlist cannot be used for SDF annotated simulation.
-- Device      : xc7a35tfgg484-2
-- --------------------------------------------------------------------------------
library IEEE;
use IEEE.STD_LOGIC_1164.ALL;
library UNISIM;
use UNISIM.VCOMPONENTS.ALL;
entity pll_pll_clk_wiz is
  port (
    clk_out1 : out STD_LOGIC;
    clk_out2 : out STD_LOGIC;
    resetn : in STD_LOGIC;
    locked : out STD_LOGIC;
    clk_in1 : in STD_LOGIC
  );
  attribute ORIG_REF_NAME : string;
  attribute ORIG_REF_NAME of pll_pll_clk_wiz : entity is "pll_clk_wiz";
end pll_pll_clk_wiz;

architecture STRUCTURE of pll_pll_clk_wiz is
  signal clk_in1_pll : STD_LOGIC;
  signal clk_out1_pll : STD_LOGIC;
  signal clk_out2_pll : STD_LOGIC;
  signal clkfbout_buf_pll : STD_LOGIC;
  signal clkfbout_pll : STD_LOGIC;
  signal reset_high : STD_LOGIC;
  signal NLW_plle2_adv_inst_CLKOUT2_UNCONNECTED : STD_LOGIC;
  signal NLW_plle2_adv_inst_CLKOUT3_UNCONNECTED : STD_LOGIC;
  signal NLW_plle2_adv_inst_CLKOUT4_UNCONNECTED : STD_LOGIC;
  signal NLW_plle2_adv_inst_CLKOUT5_UNCONNECTED : STD_LOGIC;
  signal NLW_plle2_adv_inst_DRDY_UNCONNECTED : STD_LOGIC;
  signal NLW_plle2_adv_inst_DO_UNCONNECTED : STD_LOGIC_VECTOR ( 15 downto 0 );
  attribute BOX_TYPE : string;
  attribute BOX_TYPE of clkf_buf : label is "PRIMITIVE";
  attribute BOX_TYPE of clkin1_ibufg : label is "PRIMITIVE";
  attribute CAPACITANCE : string;
  attribute CAPACITANCE of clkin1_ibufg : label is "DONT_CARE";
  attribute IBUF_DELAY_VALUE : string;
  attribute IBUF_DELAY_VALUE of clkin1_ibufg : label is "0";
  attribute IFD_DELAY_VALUE : string;
  attribute IFD_DELAY_VALUE of clkin1_ibufg : label is "AUTO";
  attribute BOX_TYPE of clkout1_buf : label is "PRIMITIVE";
  attribute BOX_TYPE of clkout2_buf : label is "PRIMITIVE";
  attribute BOX_TYPE of plle2_adv_inst : label is "PRIMITIVE";
begin
clkf_buf: unisim.vcomponents.BUFG
     port map (
      I => clkfbout_pll,
      O => clkfbout_buf_pll
    );
clkin1_ibufg: unisim.vcomponents.IBUF
    generic map(
      IOSTANDARD => "DEFAULT"
    )
        port map (
      I => clk_in1,
      O => clk_in1_pll
    );
clkout1_buf: unisim.vcomponents.BUFG
     port map (
      I => clk_out1_pll,
      O => clk_out1
    );
clkout2_buf: unisim.vcomponents.BUFG
     port map (
      I => clk_out2_pll,
      O => clk_out2
    );
plle2_adv_inst: unisim.vcomponents.PLLE2_ADV
    generic map(
      BANDWIDTH => "OPTIMIZED",
      CLKFBOUT_MULT => 18,
      CLKFBOUT_PHASE => 0.000000,
      CLKIN1_PERIOD => 20.000000,
      CLKIN2_PERIOD => 0.000000,
      CLKOUT0_DIVIDE => 18,
      CLKOUT0_DUTY_CYCLE => 0.500000,
      CLKOUT0_PHASE => 0.000000,
      CLKOUT1_DIVIDE => 27,
      CLKOUT1_DUTY_CYCLE => 0.500000,
      CLKOUT1_PHASE => 0.000000,
      CLKOUT2_DIVIDE => 1,
      CLKOUT2_DUTY_CYCLE => 0.500000,
      CLKOUT2_PHASE => 0.000000,
      CLKOUT3_DIVIDE => 1,
      CLKOUT3_DUTY_CYCLE => 0.500000,
      CLKOUT3_PHASE => 0.000000,
      CLKOUT4_DIVIDE => 1,
      CLKOUT4_DUTY_CYCLE => 0.500000,
      CLKOUT4_PHASE => 0.000000,
      CLKOUT5_DIVIDE => 1,
      CLKOUT5_DUTY_CYCLE => 0.500000,
      CLKOUT5_PHASE => 0.000000,
      COMPENSATION => "ZHOLD",
      DIVCLK_DIVIDE => 1,
      IS_CLKINSEL_INVERTED => '0',
      IS_PWRDWN_INVERTED => '0',
      IS_RST_INVERTED => '0',
      REF_JITTER1 => 0.010000,
      REF_JITTER2 => 0.010000,
      STARTUP_WAIT => "FALSE"
    )
        port map (
      CLKFBIN => clkfbout_buf_pll,
      CLKFBOUT => clkfbout_pll,
      CLKIN1 => clk_in1_pll,
      CLKIN2 => '0',
      CLKINSEL => '1',
      CLKOUT0 => clk_out1_pll,
      CLKOUT1 => clk_out2_pll,
      CLKOUT2 => NLW_plle2_adv_inst_CLKOUT2_UNCONNECTED,
      CLKOUT3 => NLW_plle2_adv_inst_CLKOUT3_UNCONNECTED,
      CLKOUT4 => NLW_plle2_adv_inst_CLKOUT4_UNCONNECTED,
      CLKOUT5 => NLW_plle2_adv_inst_CLKOUT5_UNCONNECTED,
      DADDR(6 downto 0) => B"0000000",
      DCLK => '0',
      DEN => '0',
      DI(15 downto 0) => B"0000000000000000",
      DO(15 downto 0) => NLW_plle2_adv_inst_DO_UNCONNECTED(15 downto 0),
      DRDY => NLW_plle2_adv_inst_DRDY_UNCONNECTED,
      DWE => '0',
      LOCKED => locked,
      PWRDWN => '0',
      RST => reset_high
    );
plle2_adv_inst_i_1: unisim.vcomponents.LUT1
    generic map(
      INIT => X"1"
    )
        port map (
      I0 => resetn,
      O => reset_high
    );
end STRUCTURE;
library IEEE;
use IEEE.STD_LOGIC_1164.ALL;
library UNISIM;
use UNISIM.VCOMPONENTS.ALL;
entity pll is
  port (
    clk_out1 : out STD_LOGIC;
    clk_out2 : out STD_LOGIC;
    resetn : in STD_LOGIC;
    locked : out STD_LOGIC;
    clk_in1 : in STD_LOGIC
  );
  attribute NotValidForBitStream : boolean;
  attribute NotValidForBitStream of pll : entity is true;
end pll;

architecture STRUCTURE of pll is
begin
inst: entity work.pll_pll_clk_wiz
     port map (
      clk_in1 => clk_in1,
      clk_out1 => clk_out1,
      clk_out2 => clk_out2,
      locked => locked,
      resetn => resetn
    );
end STRUCTURE;
